PhamDuyAnh/Arduino_Plasma_THC/Arduino_THC_rotary_v1.0.sch

## EAGLE design Arduino_THC_rotary_v1.0.sch (2017-09-28)

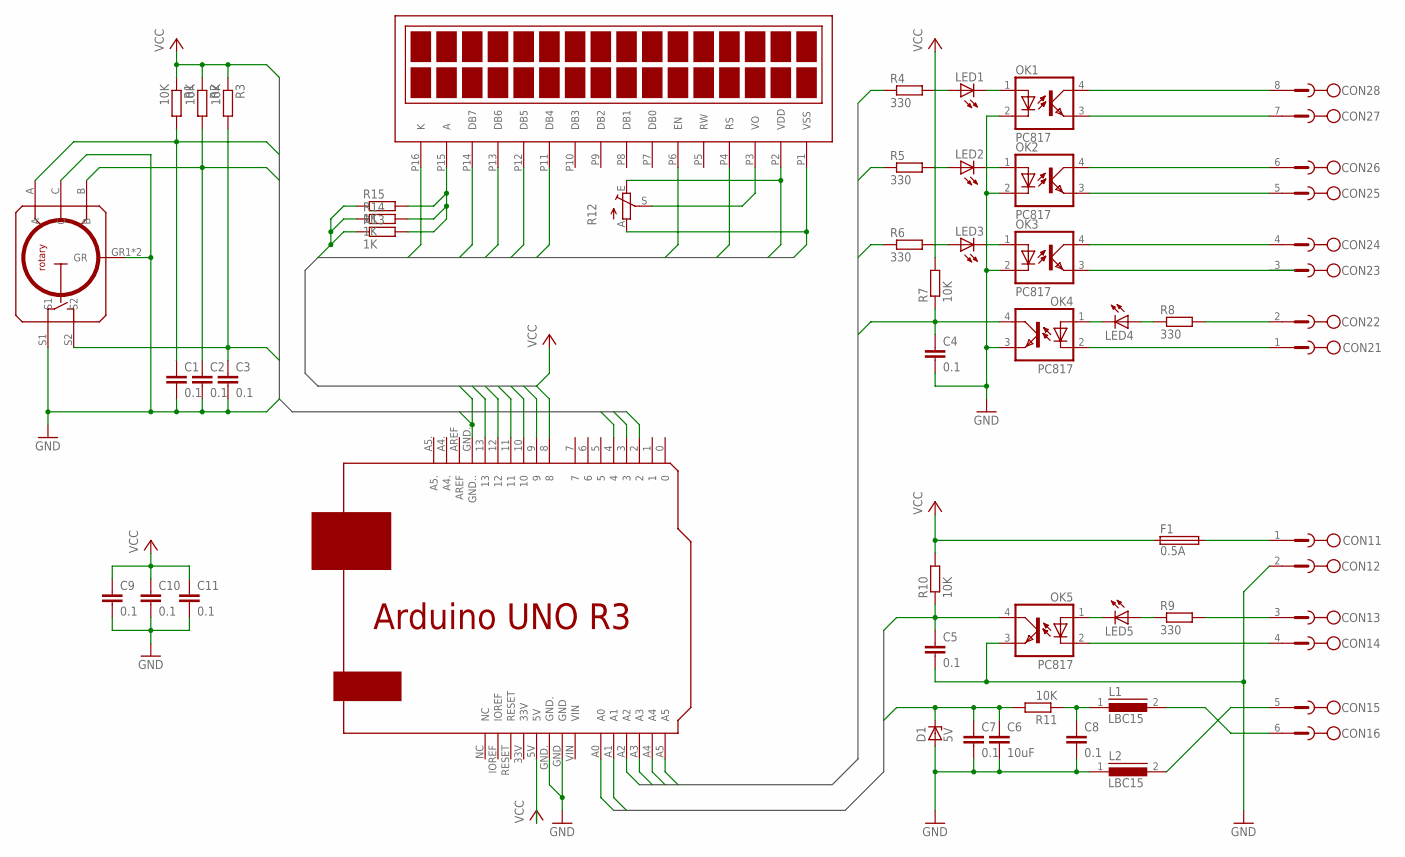
[picture p6: schematic Arduino_THC_rotary_v1.0.sch]

Parts:
C1, C2, C3, C4, C5, C7, C8, C9, C10, C11: 0.1; C5B2.5
C6: 10uF; C5B2.5
CON1: CY350-6
CON2: CY350-8
D1: 5V; DO41Z10
F1: 0.5A; SHK20L
L1, L2: LBC15
LCD: LCD16X2_HD44780
LED1, LED2, LED3, LED4, LED5: LED3MM
OK1, OK2, OK3, OK4, OK5: PC817; DIL04
R1, R2, R3, R7, R10, R11: 10K; 0207/12
R4, R5, R6, R8, R9: 330; 0207/12
R12: TRIM_EU-B25X; B25X
R13, R14, R15: 1K; 0207/12
RO: ROTARY12_24P_V_SWITCH; ROTAYRY12_24P_V_SWITCH
UNOR3: ARDUINO_UNO_R3

Connections:
DB4: LCD.P11 (DB4), UNOR3.11
DB5: LCD.P12 (DB5), UNOR3.10
DB6: LCD.P13 (DB6), UNOR3.9
DB7: LCD.P14 (DB7), UNOR3.8
EN: LCD.P6 (EN), UNOR3.12
GND: C1.2, C2.2, C3.2, C4.2, C5.2, C6.2, C7.2, C8.2, C9.2, C10.2, C11.2, CON1.2, D1.A, L2.1, LCD.P1 (VSS), LCD.P16 (K), OK1.2 (C), OK2.2 (C), OK3.2 (C), OK4.3 (EMIT), OK5.3 (EMIT), R12.A, RO.C, RO.GR1 (GR), RO.S1, UNOR3.GND, UNOR3.GND., UNOR3.GND..
I2: C1.1, R1.2, RO.A, UNOR3.2
I3: C2.1, R2.2, RO.B, UNOR3.3
I4: C3.1, R3.2, RO.S2, UNOR3.4
IA0: C6.1, C7.1, D1.C, R11.2, UNOR3.A0
IA1: C5.1, OK5.4 (COL), R10.1, UNOR3.A1
IA2: C4.1, OK4.4 (COL), R7.1, UNOR3.A2
unnamed: LED4.A, R8.1
unnamed: LED1.A, R4.2
unnamed: LED1.K (C), OK1.1 (A)
unnamed: CON1.6, L1.2
unnamed: LED2.A, R5.2
unnamed: LCD.P15 (A), R13.2, R14.2, R15.2
unnamed: LED2.K (C), OK2.1 (A)
unnamed: LED3.A, R6.2
unnamed: LED3.K (C), OK3.1 (A)
unnamed: CON1.5, L2.2
unnamed: CON1.1, F1.2A
unnamed: CON1.3, R9.2
unnamed: CON1.4, OK5.2 (C)
unnamed: CON2.3, OK3.3 (EMIT)
unnamed: CON2.2, R8.2
unnamed: CON2.1, OK4.2 (C)
unnamed: LCD.P3 (VO), R12.S
unnamed: CON2.4, OK3.4 (COL)
unnamed: LED5.K (C), OK5.1 (A)
unnamed: LED5.A, R9.1
unnamed: CON2.5, OK2.3 (EMIT)
unnamed: CON2.6, OK2.4 (COL)
unnamed: CON2.7, OK1.3 (EMIT)
unnamed: LED4.K (C), OK4.1 (A)
unnamed: CON2.8, OK1.4 (COL)
unnamed: C8.1, L1.1, R11.1
OA3: R6.1, UNOR3.A3
OA4: R5.1, UNOR3.A4
OA5: R4.1, UNOR3.A5
RS: LCD.P4 (RS), UNOR3.13
VCC: C9.1, C10.1, C11.1, F1.1A, LCD.P2 (VDD), R1.1, R2.1, R3.1, R7.2, R10.2, R12.E, R13.1, R14.1, R15.1, UNOR3.5V
