PhamDuyAnh/Arduino_Plasma_THC/(threads)

Thread 1 (2019-07-28):

arduino uno how to upload

manisaranbala, 2019-07-28:
I try your circuit Arduino UNO how to upload. upload failed error

Thread 2 (2020-12-19):

part value

rudehardware, 2020-12-19:
What is value for capacitor, inductor and dioder for voltage divider? thnks

PhamDuyAnh, 2020-12-21:
Hi!
My project uses hypertherm plasma source, it has a voltage divider
available.  My circuit was redesigned from the information I found on
google.  I have never tested it before, so it is not clear the value.

https://github.com/PhamDuyAnh/Arduino_Plasma_THC/blob/master/THC-voltage-divider-2.jpg

In the picture!  Inductors and capacitors have the noise filter and
blocking HF (pilot arc).  I think <5uH and about 470nF600V

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

rudehardware, 2020-12-24:
hyperterm uses 1:50 or 1:20 volt divider?

PhamDuyAnh, 2020-12-24:
It's multi optional.
I used 1:50, max output voltage is 6V.
But averaging about 2-3V (equivalent to 100-150V plasma voltage)

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

rudehardware, 2020-12-24:
ok thanks for the info. im starting to build :)

Thread 3 (2023-08-21):

Not uploading  to Uno

Lgagnon43, 2023-08-21:
Hello im tring to uplaod your code and it seem not to work im getting this followeing error:

#C:\Users\loup1\Desktop\CNC Plasma Cutter\A etudier\Arduino_Plasma_THC-master\Arduino_Plasma_THC-master\Arduino_THC_rotary\Arduino_THC_rotary.ino: In function 'void setup()':
C:\Users\loup1\Desktop\CNC Plasma Cutter\A etudier\Arduino_Plasma_THC-master\Arduino_Plasma_THC-master\Arduino_THC_rotary\Arduino_THC_rotary.ino:83:3: error: 'Setup_Encoder' was not declared in this scope
   Setup_Encoder();
   ^~~~~~~~~~~~~
C:\Users\loup1\Desktop\CNC Plasma Cutter\A etudier\Arduino_Plasma_THC-master\Arduino_Plasma_THC-master\Arduino_THC_rotary\Arduino_THC_rotary.ino:84:3: error: 'Setup_LCD' was not declared in this scope
   Setup_LCD();
   ^~~~~~~~~
C:\Users\loup1\Desktop\CNC Plasma Cutter\A etudier\Arduino_Plasma_THC-master\Arduino_Plasma_THC-master\Arduino_THC_rotary\Arduino_THC_rotary.ino:85:3: error: 'Setup_THC' was not declared in this scope
   Setup_THC();
   ^~~~~~~~~
C:\Users\loup1\Desktop\CNC Plasma Cutter\A etudier\Arduino_Plasma_THC-master\Arduino_Plasma_THC-master\Arduino_THC_rotary\Arduino_THC_rotary.ino:86:3: error: 'Setup_Timer2' was not declared in this scope
   Setup_Timer2();
   ^~~~~~~~~~~~
C:\Users\loup1\Desktop\CNC Plasma Cutter\A etudier\Arduino_Plasma_THC-master\Arduino_Plasma_THC-master\Arduino_THC_rotary\Arduino_THC_rotary.ino:88:3: error: 'ReadData' was not declared in this scope
   ReadData();
   ^~~~~~~~
C:\Users\loup1\Desktop\CNC Plasma Cutter\A etudier\Arduino_Plasma_THC-master\Arduino_Plasma_THC-master\Arduino_THC_rotary\Arduino_THC_rotary.ino: In function 'void loop()':
C:\Users\loup1\Desktop\CNC Plasma Cutter\A etudier\Arduino_Plasma_THC-master\Arduino_Plasma_THC-master\Arduino_THC_rotary\Arduino_THC_rotary.ino:104:3: error: 'checkButton' was not declared in this scope
   checkButton();
   ^~~~~~~~~~~
C:\Users\loup1\Desktop\CNC Plasma Cutter\A etudier\Arduino_Plasma_THC-master\Arduino_Plasma_THC-master\Arduino_THC_rotary\Arduino_THC_rotary.ino:105:3: error: 'checkMenu' was not declared in this scope
   checkMenu();
   ^~~~~~~~~
C:\Users\loup1\Desktop\CNC Plasma Cutter\A etudier\Arduino_Plasma_THC-master\Arduino_Plasma_THC-master\Arduino_THC_rotary\Arduino_THC_rotary.ino:106:3: error: 'doTHC' was not declared in this scope
   doTHC();
   ^~~~~
C:\Users\loup1\Desktop\CNC Plasma Cutter\A etudier\Arduino_Plasma_THC-master\Arduino_Plasma_THC-master\Arduino_THC_rotary\Arduino_THC_rotary.ino:107:3: error: 'doLCD' was not declared in this scope
   doLCD();
   ^~~~~

exit status 1

Compilation error: 'Setup_Encoder' was not declared in this scope

#2

Could you help me ?

Lgagnon43, 2023-08-21:
solved

PhamDuyAnh, 2023-08-21:
Hi!

Hope you can use it soon!

If possible!  Can you share the result with me :D

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

Lgagnon43, 2023-08-21:
Hello
My plasma cutter is a 20:1 ratio what would i need to modified to the circuit ?
Do i still need the optocoupler ?

Also dit some mods to intégration à 20x4 i2c lcd screen to your work.

PhamDuyAnh, 2023-08-22:
Hi!
In the arduino code, there is a constant "divRato" for the purpose of
adjusting the factor to match the voltage dividers.
The circuit does not focus on the voltage divider.  If you use hypertherm
its voltage divider is very good quality.  If not hypertherm's, i think you
better use a voltage divider circuit.
Otherwise the HV component of the plasma source can damage the arduino
circuit.

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

Lgagnon43, 2023-08-24:
Hello
I have one other question i dont now if you coulb help me to wire up the THC to my cnc.
 Wirring fo my CNC
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
The CNC plug on my plasma cuter
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
And  this is your skematic
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

What gos where ? sorry im still a bigenner in this.

Thanks in advensce for the help.

PhamDuyAnh, 2023-08-27:
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

My THC circuit cannot be used with these controllers.  It measures the plasma voltage, and outputs an up/down signal that drives the z-axis.  Therefore, it can only work with plasma controllers that have up/down input.  For DIYer, Mach3 is an example.
